LaheyKevin/Applied-IoT-Project-PoAB/relaismsofet correctie/relaismsofet correctie.png

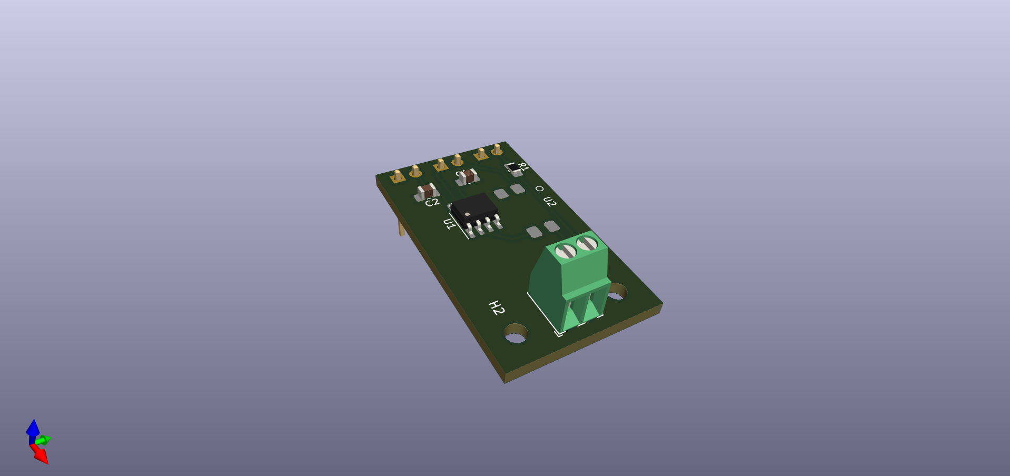
relaismsofet correctie/relaismsofet correctie.png
