LaheyKevin/Applied-IoT-Project-PoAB/stcs05/stc05-isoview.png

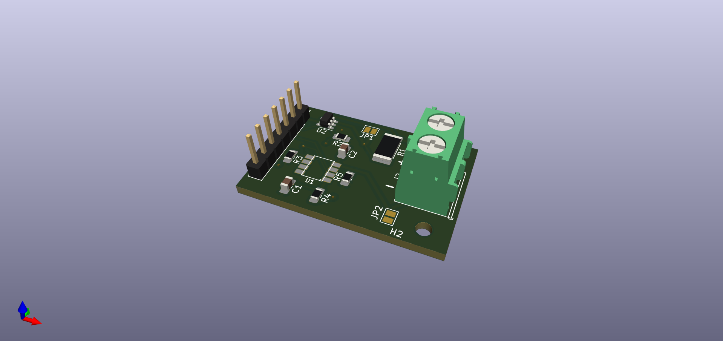
stcs05/stc05-isoview.png
