LaheyKevin/Applied-IoT-Project-PoAB/current regulator.docx

Current and voltage regulator

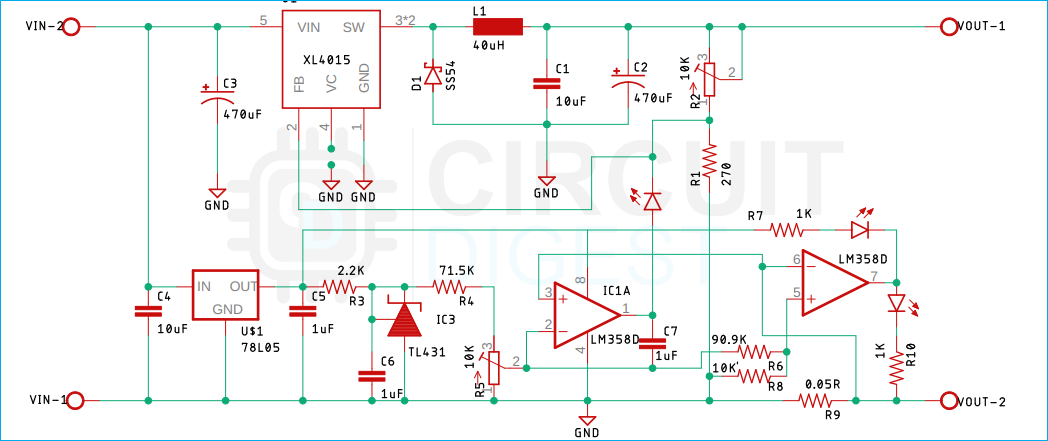
[picture p4: figure]
XL4015 DC-DC Buck Converter Schematic

Nadeel: chip moeilijk te vinden, circuit bevat batterijmeting die niet nodig is.

LM2673-adj

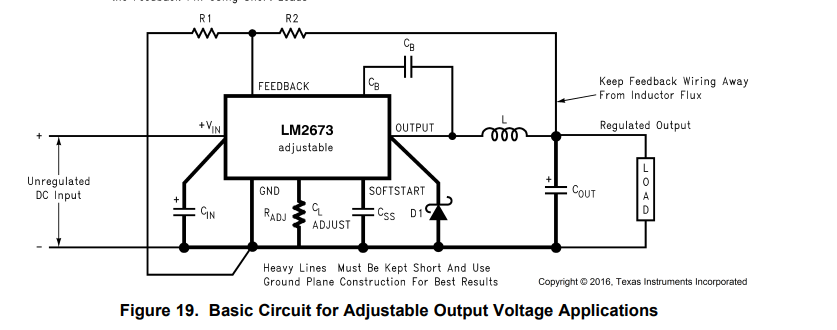
[picture p5: figure]

Te vinden op digikey,farnel, … vrij eenvoudig circuit.

Current sensor

Ina169:

IS=1A max

(3.3V * 1kΩ)/1A = 3300Ω
