LaheyKevin/Applied-IoT-Project-PoAB/POAB-aansturinglamp-Gerome-DeWilde.docx

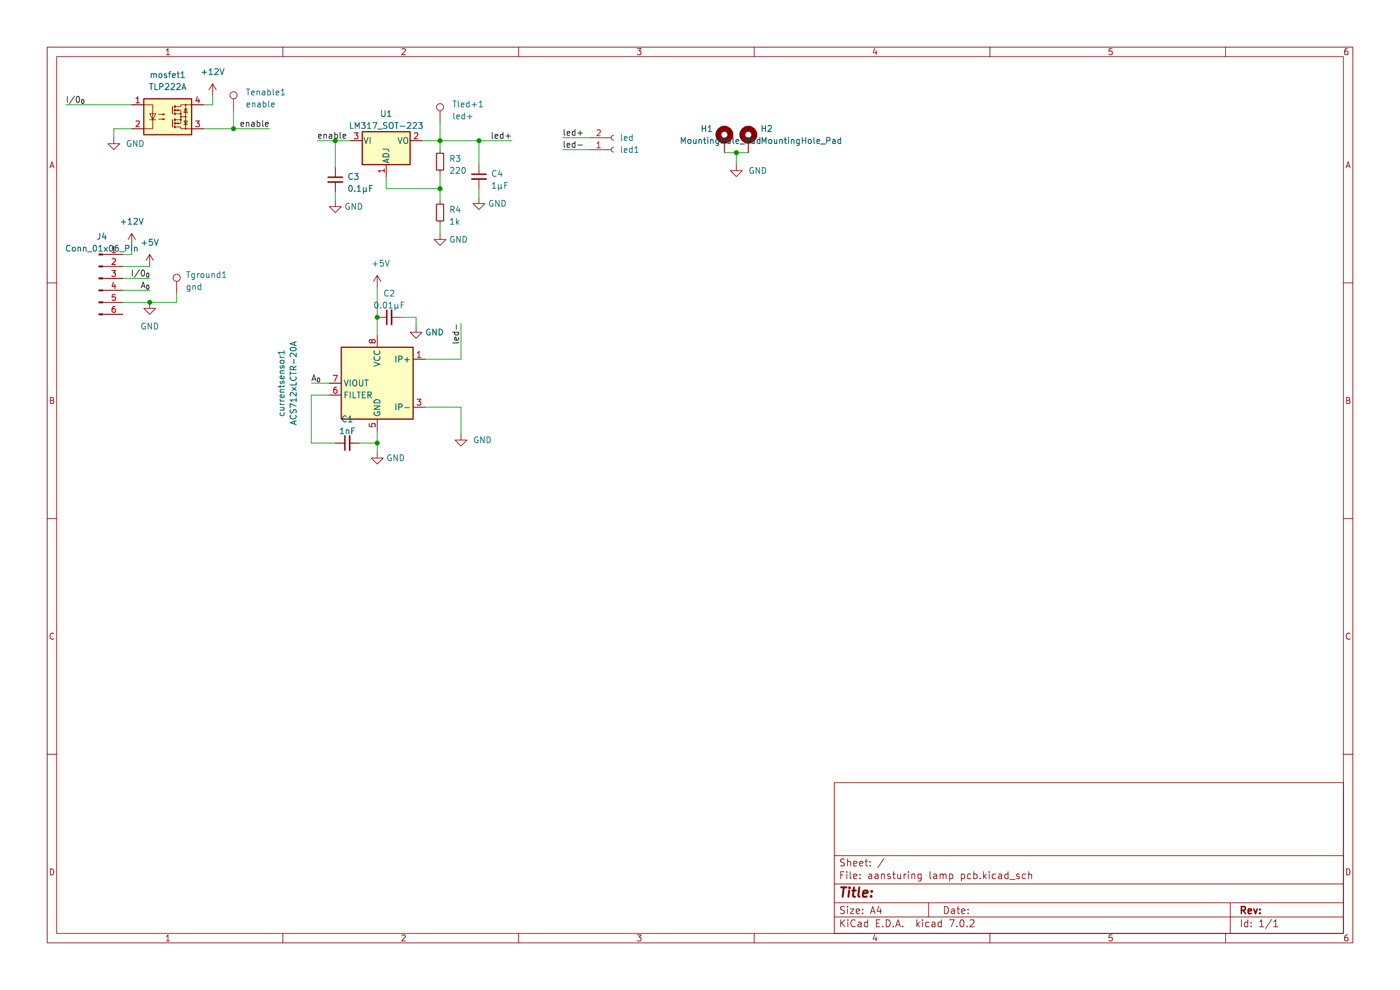
[picture p14: figure]
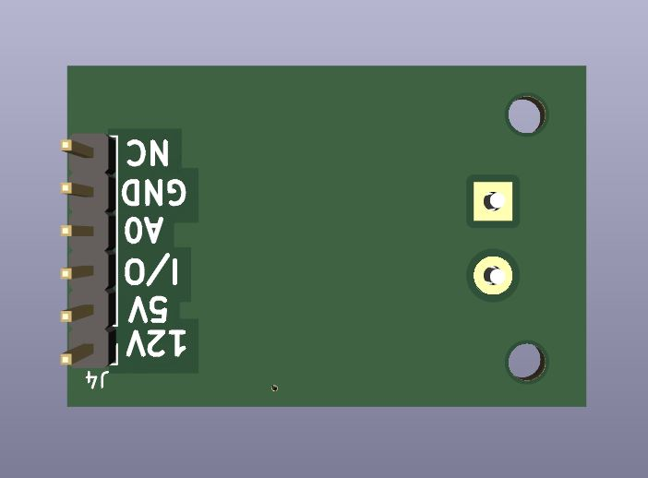
[picture p15: figure]
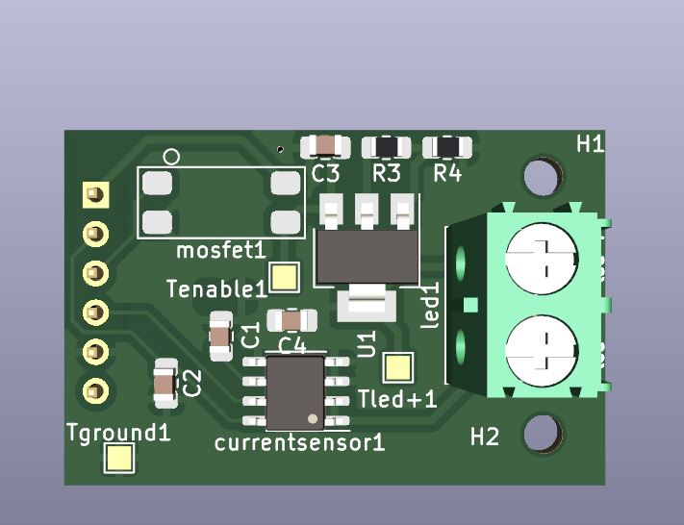
[picture p16: figure]
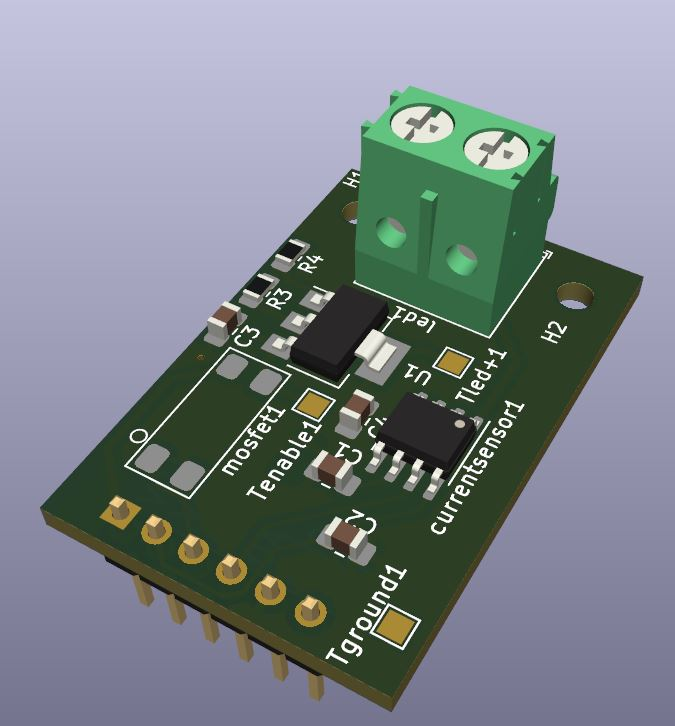
[picture p17: figure]
