LaheyKevin/Applied-IoT-Project-PoAB/baseboard/pcb design.PNG

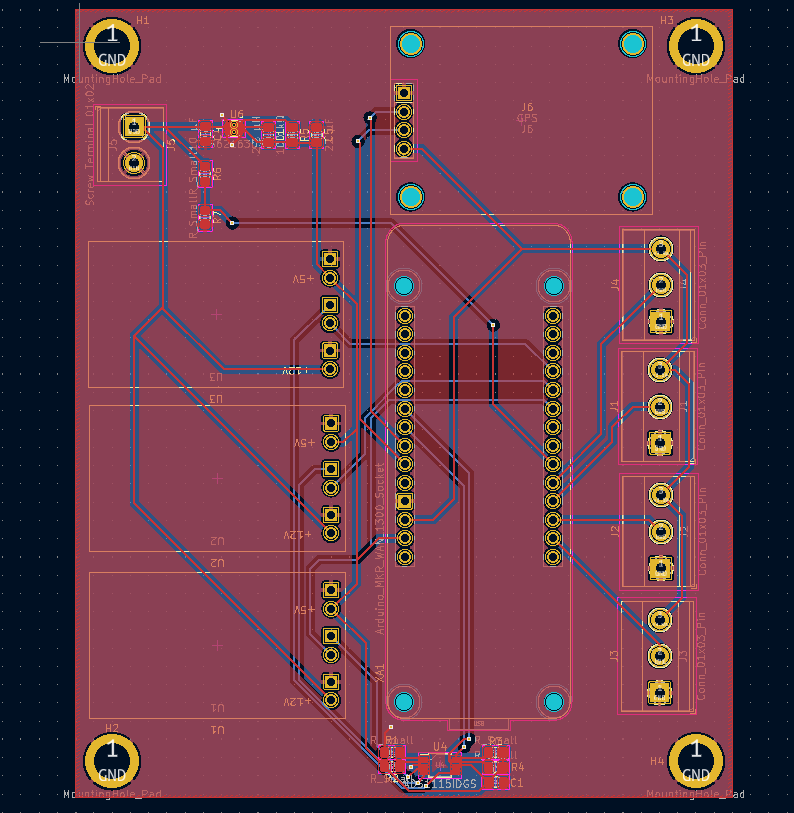
baseboard/pcb design.PNG
