LaheyKevin/Applied-IoT-Project-PoAB/elektisch schema.png

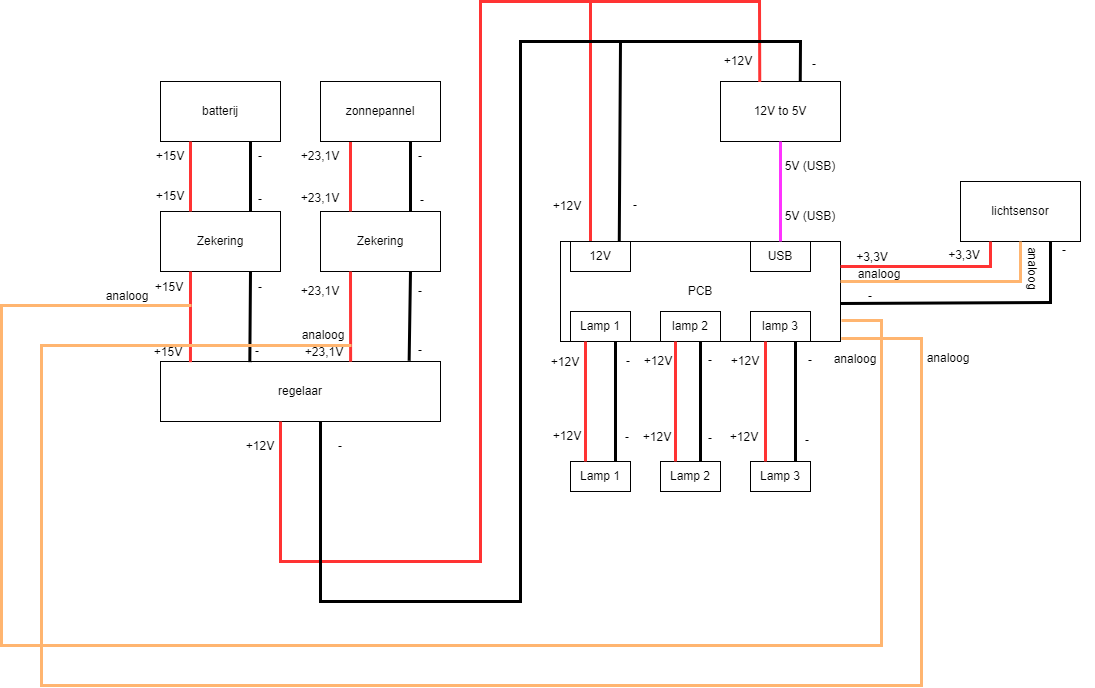
elektisch schema.png
