LaheyKevin/Applied-IoT-Project-PoAB/relaismsofet correctie/pcb design.PNG

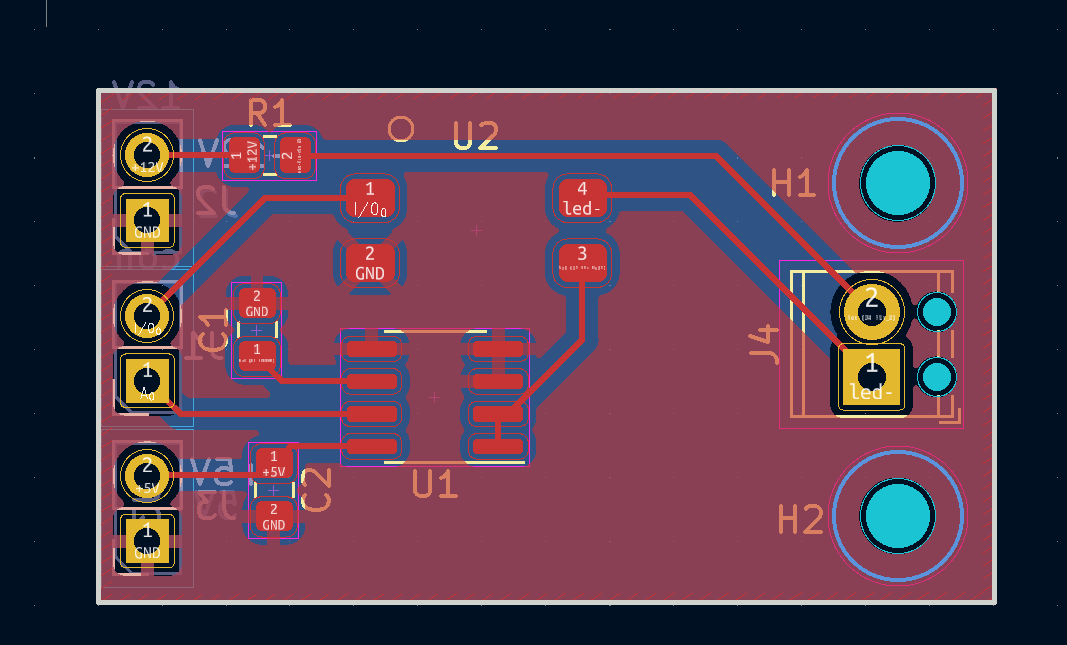
relaismsofet correctie/pcb design.PNG
