LaheyKevin/Applied-IoT-Project-PoAB/stcs05/pcb-design.PNG

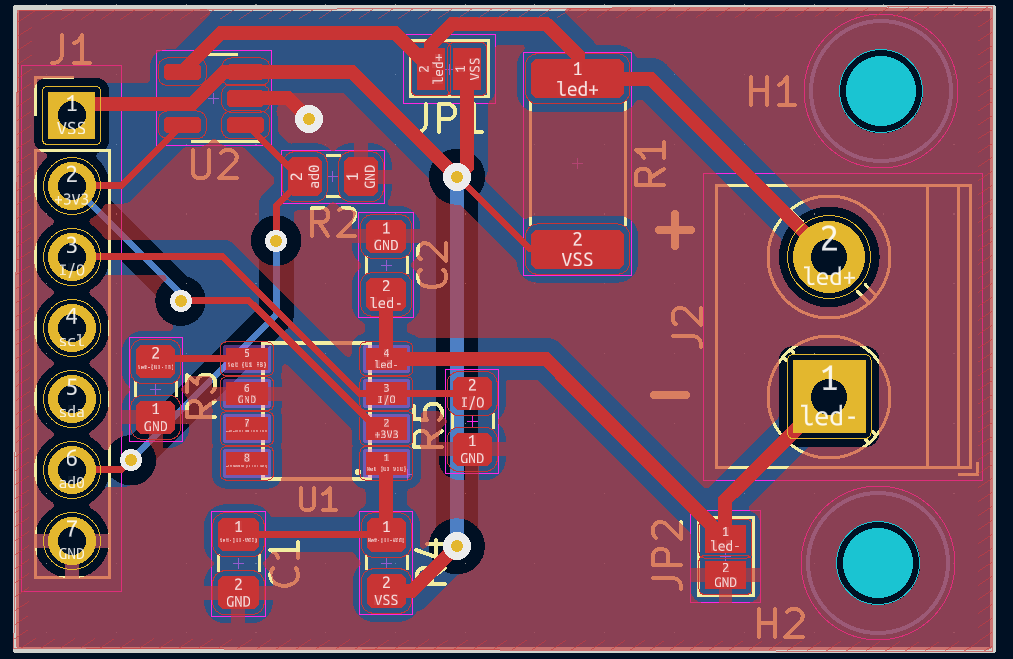
stcs05/pcb-design.PNG
