LaheyKevin/Applied-IoT-Project-PoAB/yorick_baseboard/baseboard/PCB-POAB-baseboard-3dview.png

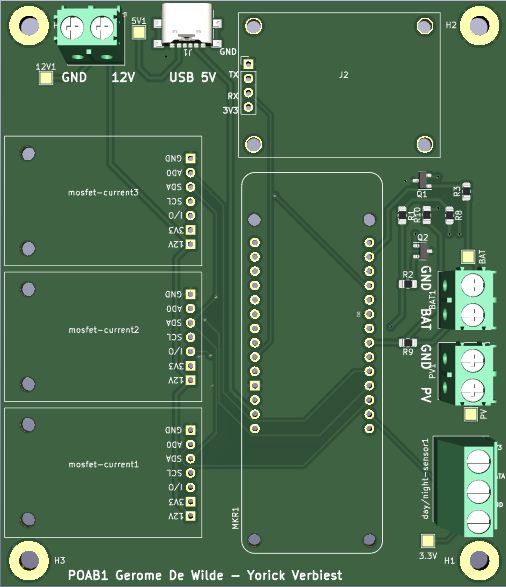
yorick_baseboard/baseboard/PCB-POAB-baseboard-3dview.png
