LaheyKevin/Applied-IoT-Project-PoAB/yorick_baseboard/baseboard/PCB-POAB-baseboard.png

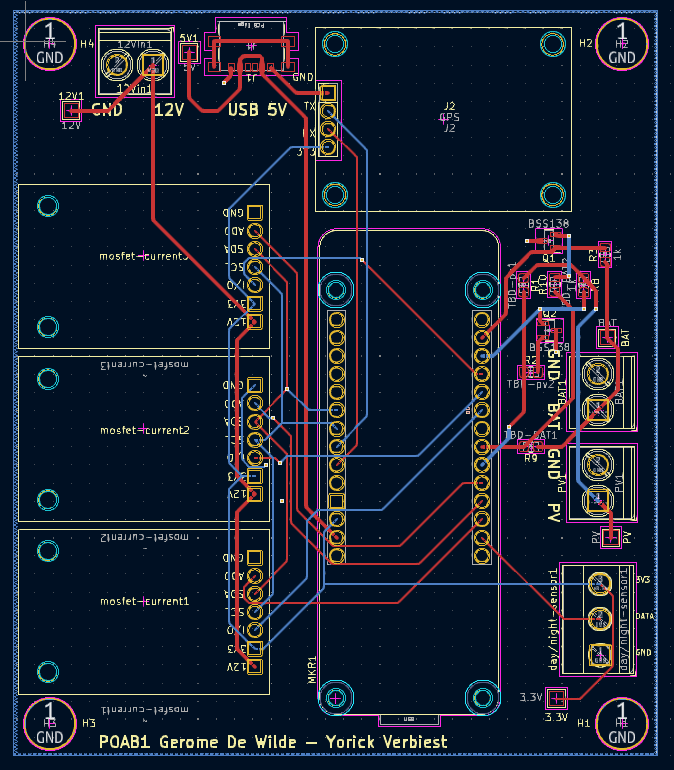
yorick_baseboard/baseboard/PCB-POAB-baseboard.png
