LaheyKevin/Applied-IoT-Project-PoAB/bestellijst light sensor.xlsx

 | light sensor
naam | link | aantal | prijs per stuk | prijs
light sensor | https://be.farnell.com/w/search/prl/resultaten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 | 1 | 1.38 | 1.38
10k ohm | https://be.farnell.com/yageo/rc0805fr-0710kl/res-10k-1-0-125w-0805-thick-film/dp/9237755 | 10 | 0.018 | 0.18
pcb | https://cart.jlcpcb.com/quote/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 | 5 |  | 1.82
 |  |  | totaal | 3.38
