LaheyKevin/Applied-IoT-Project-PoAB/bestellijst steering board.xlsx

 |  | steering board
naam | waarde | link | aantal | prijs per stuk | prijs
led-driver | stcs05 | https://be.farnell.com/stmicroelectronics/stcs05dr/led-driver-constant-current-soic/dp/3367114?st=stcs05 | 3 | 1.06 | 3.18
weerstand | 100 ohm | https://be.farnell.com/yageo/rc0805fr-07100rl/res-100r-1-0-125w-0805-thick-film/dp/9237364 | 10 | 0.018 | 0.18
weerstand | 470 ohm | https://be.farnell.com/yageo/rc0805fr-07470rl/res-470r-1-0-125w-0805-thick-film/dp/9237445 | 10 | 0.018 | 0.18
condensator | 0,47µF | https://be.farnell.com/tdk/cga4j3x8r1e474k125ad/cap-0-47-f-25v-10-x8r-0805/dp/2907072 | 5 | 0.045 | 0.225
condensator | 0,1µF | https://be.farnell.com/avx/08053c104jat2a/cap-0-1-f-25v-5-x7r-0805/dp/2332733 | 10 | 0.109 | 1.09
weerstand | 1 ohm | https://be.farnell.com/susumu/rl1220s-1r0-f/current-sense-res-1r-1-333-mw/dp/1612056 | 3 | 0.31 | 0.93
stroom-meter | ina169 | https://be.farnell.com/texas-instruments/ina169na-250/current-sense-amp-440khz-sot23/dp/3118124?st=ina169 | 3 | 2.66 | 7.98
weerstand | 10 ohm | https://be.farnell.com/bourns/crm2512-jw-1r0elf/current-sense-res-1r-5-2-w-2512/dp/1865268?ost=1865268 | 10 | 0.253 | 2.53
weerstand | 3k3 ohm | https://be.farnell.com/yageo/rc0805fr-073k3l/res-3k3-1-0-125w-0805-thick-film/dp/9237682 | 10 | 0.018 | 0.18
headers | 1x7 pin header | https://be.farnell.com/multicomp/2211s-07g/connector-header-7pos-1row-2-54mm/dp/2847165 | 1 | 0.047 | 0.047
screw terminal | screw terminal | https://be.farnell.com/multicomp/mc000046/terminal-block-wire-to-brd-2pos/dp/2008017?st=screw%20terminal%20pcb | 5 | 0.348 | 1.74
pcb | pcb | https://cart.jlcpcb.com/quote/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 | 5 |  | 3.64
 |  |  |  | totaal | 21.902
