LaheyKevin/Applied-IoT-Project-PoAB/relaismsofet correctie/relaismsofet correctie.pdf

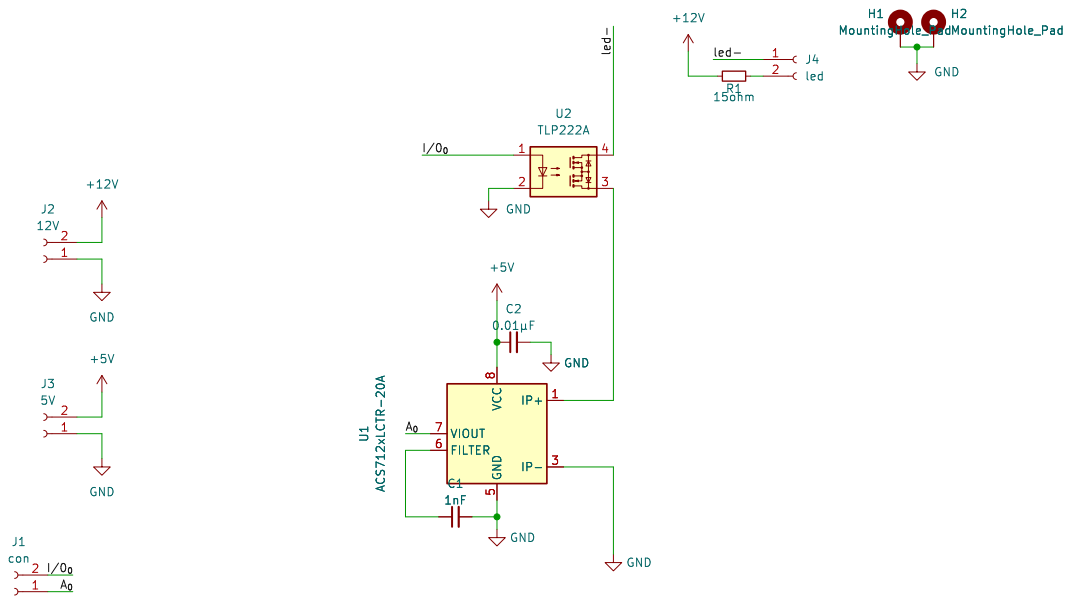
[picture p24: page 1]

Id: 1/1 Title: File: relaismosfet.kicad_sch Sheet: / GND
