LaheyKevin/Applied-IoT-Project-PoAB/yorick_baseboard/baseboard/PCB-POAB-baseboard-schema.pdf

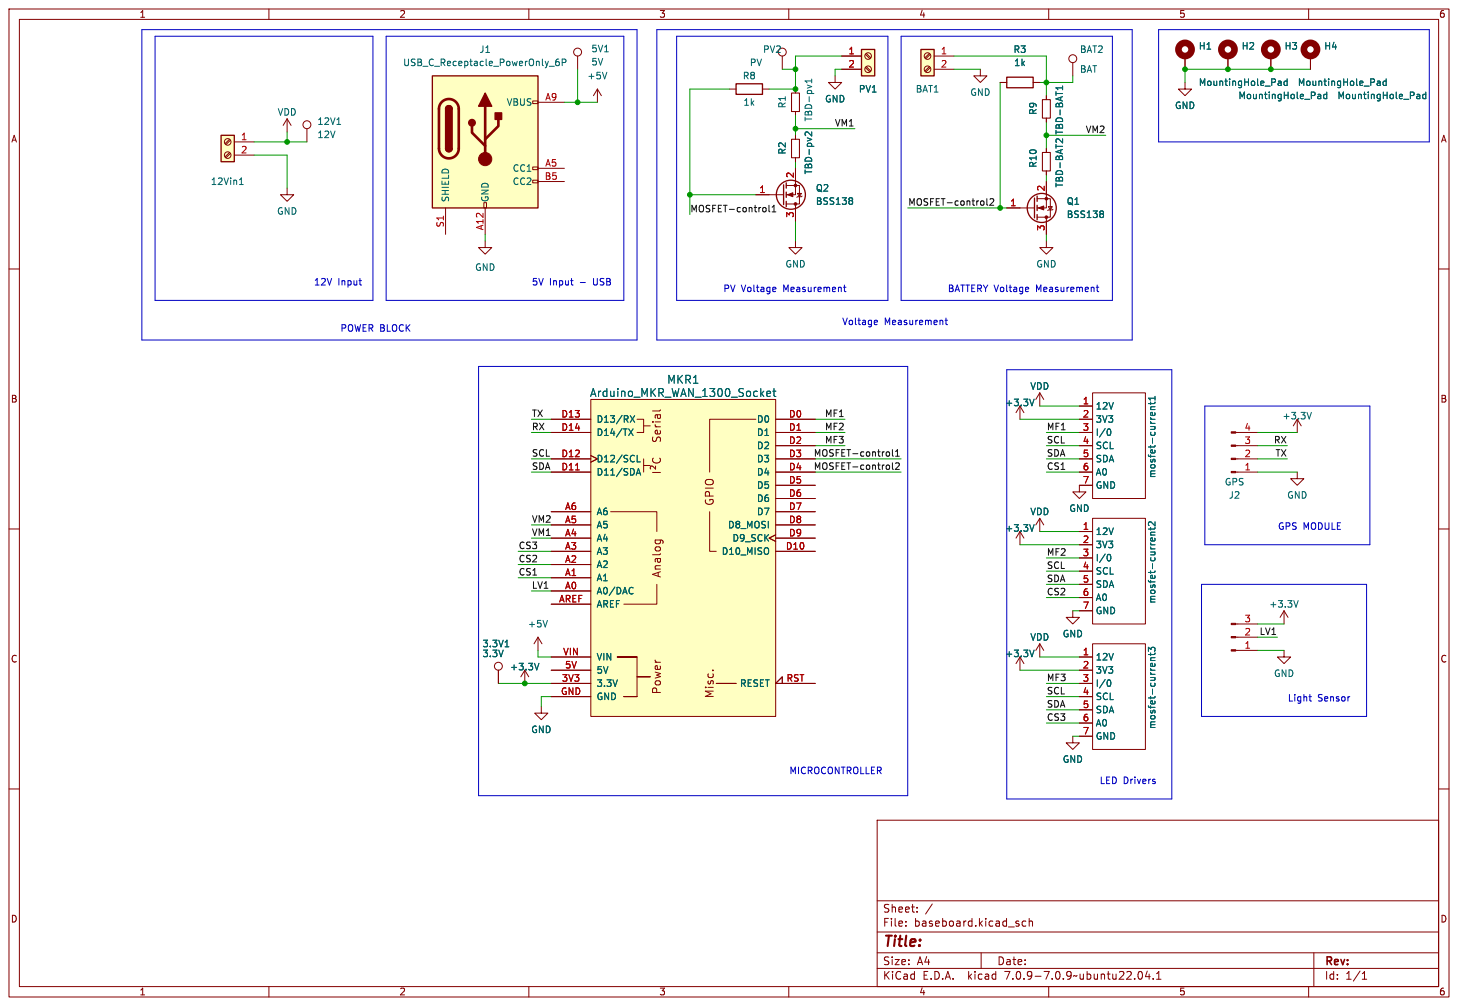
[picture p25: page 1]

Id: 1/1 Title: File: baseboard.kicad_sch Sheet: /
