LaheyKevin/Applied-IoT-Project-PoAB/baseboard/baseboard.pdf

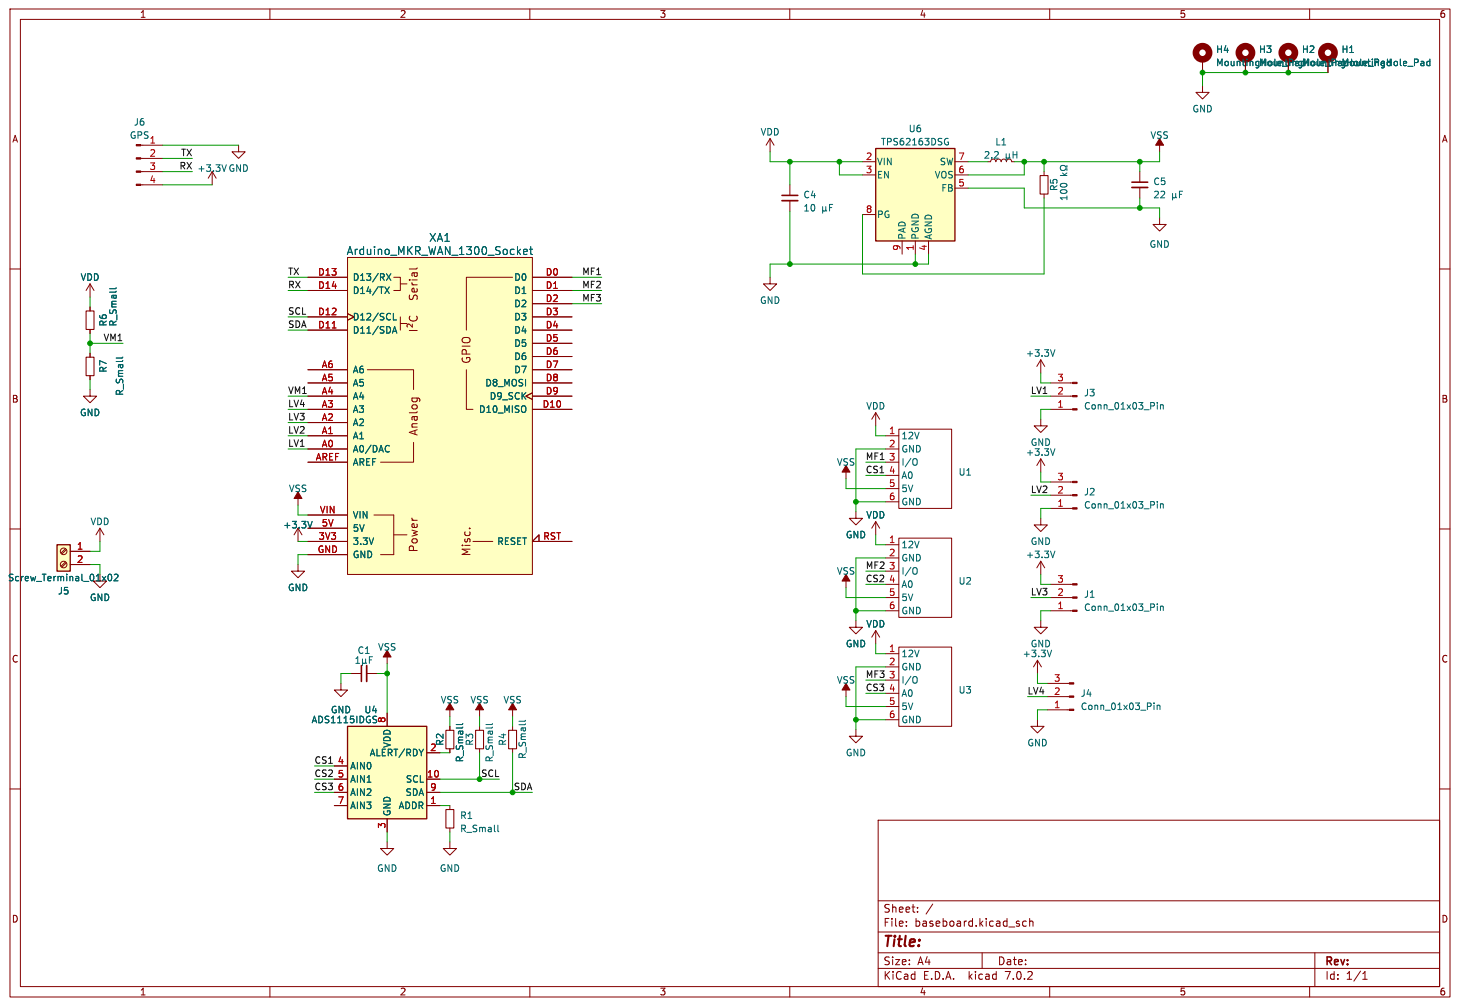
[picture p26: page 1]
