LaheyKevin/Applied-IoT-Project-PoAB/AL5801/testboard AL5801.kicad_pcb

## KiCad design AL5801/testboard AL5801.kicad_pcb (2024-01-11)

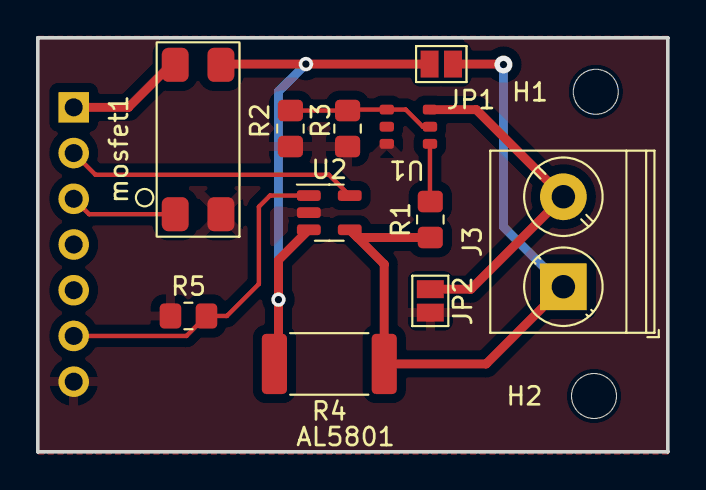
[picture p27: board testboard AL5801.kicad_pcb from above]

Board: 2 copper layers, 35.0 x 23.0 mm, 14 parts (1 on the bottom side), 10 nets.

Parts:
H1, H2: MountingHole_Pad; MountingHole_2.5mm
J1: Conn_01x07_Pin; PinHeader_1x07_P2.54mm_Vertical
J3: Screw_Terminal_01x02; TerminalBlock_Phoenix_PT-1,5-2-5.0-H_1x02_P5.00mm_Horizontal
JP1, JP2: SolderJumper_2_Open; SolderJumper-2_P1.3mm_Open_Pad1.0x1.5mm
R1, R2, R3: R; R_0805_2012Metric_Pad1.20x1.40mm_HandSolder
R4: Rs; R_2512_6332Metric_Pad1.40x3.35mm_HandSolder
R5: Rl; R_0805_2012Metric_Pad1.20x1.40mm_HandSolder
U1: AL5801W6-7; AL5801
U2: INA169; SOT-23-5
mosfet1: TLP222A; AQY211EHAZ

Connections:
+3V3: J1.2, U2.5 (V+)
/I/O: J1.3, mosfet1.1
/V_{in+}: JP1.1 (A), R4.2, U2.3 (+), mosfet1.3
/ad0: J1.6, R5.2, U2.1
/led+: J3.1, JP1.2 (B), R1.1, R4.1, U2.4 (-)
/led-: J3.2, JP2.1 (A), U1.3 (OUT)
GND: J1.7, JP2.2 (B), R2.2, R3.2, R5.1, U1.6 (GND), U2.2 (GND), mosfet1.2
unnamed: R1.2, U1.1 (BIAS)
unnamed: R2.1, R3.1, U1.2 (FB), U1.4 (REXT)
VSS: J1.1, mosfet1.4
