LaheyKevin/Applied-IoT-Project-PoAB/yorick_baseboard/baseboard/baseboard.kicad_pcb

## KiCad design yorick_baseboard/baseboard/baseboard.kicad_pcb (2024-01-11)

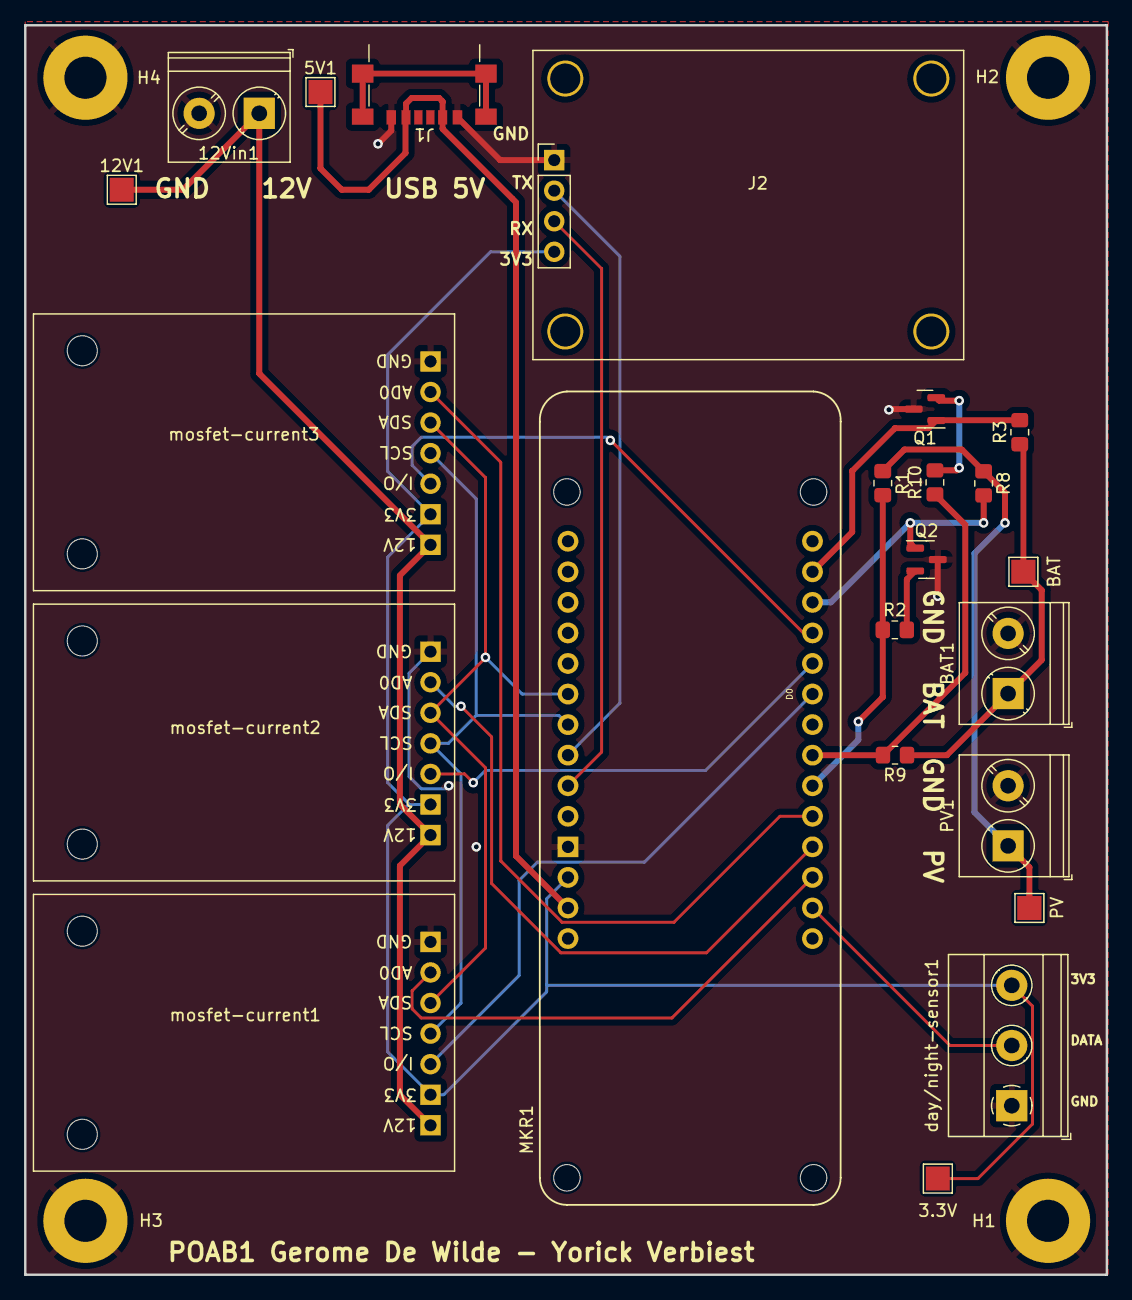
[picture p28: board yorick_baseboard/baseboard/baseboard.kicad_pcb from above]

Board: 2 copper layers, 89.9 x 103.8 mm, 27 parts (0 on the bottom side), 23 nets.

Parts:
3.3V: 3.3V; TestPoint_Pad_2.0x2.0mm
5V1: 5V; TestPoint_Pad_2.0x2.0mm
12V1: 12V; TestPoint_Pad_2.0x2.0mm
12Vin1: Screw_Terminal_01x02; TerminalBlock_Phoenix_PT-1,5-2-5.0-H_1x02_P5.00mm_Horizontal
BAT: BAT; TestPoint_Pad_2.0x2.0mm
BAT1: Screw_Terminal_01x02; TerminalBlock_Phoenix_PT-1,5-2-5.0-H_1x02_P5.00mm_Horizontal
H1, H2, H3, H4: MountingHole_Pad; MountingHole_3.5mm_Pad
J1: USB_C_Receptacle_PowerOnly_6P; USB_C_Receptacle_GCT_USB4135-GF-A_6P_TopMnt_Horizontal
J2: GPS; GYS-GPS
MKR1: Arduino_MKR_WAN_1300_Socket; Arduino_MKR_FOX_1200_Socket
PV: PV; TestPoint_Pad_2.0x2.0mm
PV1: Screw_Terminal_01x02; TerminalBlock_Phoenix_PT-1,5-2-5.0-H_1x02_P5.00mm_Horizontal
Q1, Q2: BSS138; SOT-23
R1: TBD-pv1; R_0805_2012Metric_Pad1.20x1.40mm_HandSolder
R2: TBD-pv2; R_0805_2012Metric_Pad1.20x1.40mm_HandSolder
R3, R8: 1k; R_0805_2012Metric_Pad1.20x1.40mm_HandSolder
R9: TBD-BAT1; R_0805_2012Metric_Pad1.20x1.40mm_HandSolder
R10: TBD-BAT2; R_0805_2012Metric_Pad1.20x1.40mm_HandSolder
day/night-sensor1: Conn_01x03_Pin; TerminalBlock_Phoenix_MKDS-1,5-3_1x03_P5.00mm_Horizontal
mosfet-current1, mosfet-current2, mosfet-current3: mosfet-current

Connections:
+3.3V: 3.3V.1, J2.4, MKR1.3V3 (3.3V), day/night-sensor1.3, mosfet-current1.2 (3V3), mosfet-current2.2 (3V3), mosfet-current3.2 (3V3)
+5V: 5V1.1, J1.A9 (VBUS), J1.B9 (VBUS), MKR1.VIN
/CS1: MKR1.A1, mosfet-current1.6 (A0)
/CS2: MKR1.A2, mosfet-current2.6 (A0)
/CS3: MKR1.A3, mosfet-current3.6 (A0)
/LV1: MKR1.A0 (A0/DAC), day/night-sensor1.2
/MF1: MKR1.D0, mosfet-current1.3 (I/0)
/MF2: MKR1.D1, mosfet-current2.3 (I/0)
/MF3: MKR1.D2, mosfet-current3.3 (I/0)
/MOSFET-control1: MKR1.D3, Q2.1 (G), R8.2
/MOSFET-control2: MKR1.D4, Q1.1 (G), R3.2
/RX: J2.3, MKR1.D14 (D14/TX)
/SCL: MKR1.D12 (D12/SCL), mosfet-current1.4 (SCL), mosfet-current2.4 (SCL), mosfet-current3.4 (SCL)
/SDA: MKR1.D11 (D11/SDA), mosfet-current1.5 (SDA), mosfet-current2.5 (SDA), mosfet-current3.5 (SDA)
/TX: J2.2, MKR1.D13 (D13/RX)
/VM1: MKR1.A4, R1.2, R2.1
/VM2: MKR1.A5, R9.2, R10.1
GND: 12Vin1.2, BAT1.2, H1.1, H2.1, H3.1, H4.1, J1.A12 (GND), J1.B12 (GND), J2.1, MKR1.GND, PV1.2, Q1.3 (D), Q2.3 (D), day/night-sensor1.1, mosfet-current1.7 (GND), mosfet-current2.7 (GND), mosfet-current3.7 (GND)
unnamed: BAT.1, BAT1.1, R3.1, R9.1
unnamed: PV.1, PV1.1, R1.1, R8.1
unnamed: Q1.2 (S), R10.2
unnamed: Q2.2 (S), R2.2
VDD: 12V1.1, 12Vin1.1, mosfet-current1.1 (12V), mosfet-current2.1 (12V), mosfet-current3.1 (12V)
