LaheyKevin/Applied-IoT-Project-PoAB/board_TEMT6000_waterclosedcase/board_TEMT6000_waterclosedcase.kicad_pcb

## KiCad design board_TEMT6000_waterclosedcase/board_TEMT6000_waterclosedcase.kicad_pcb (2024-01-11)

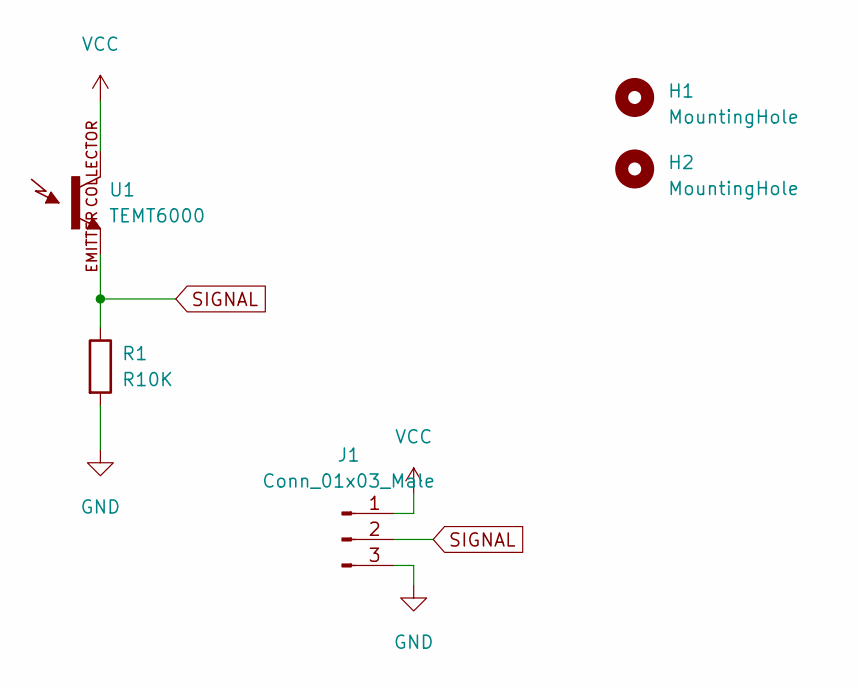
[picture p29: schematic board_TEMT6000_waterclosedcase.kicad_sch]

Parts:
H1, H2: MountingHole; MountingHole_3.2mm_M3_DIN965_Pad_TopOnly
J1: Conn_01x03_Male; SolderWire-0.1sqmm_1x03_P3.6mm_D0.4mm_OD1mm_Relief
R1: R10K; R_0805_2012Metric_Pad1.20x1.40mm_HandSolder
U1: TEMT6000; TEMT6000-SEN

Connections:
GND: J1.3, R1.2
SIGNAL: J1.2, R1.1, U1.EMITTER
VCC: J1.1, U1.COLLECTOR

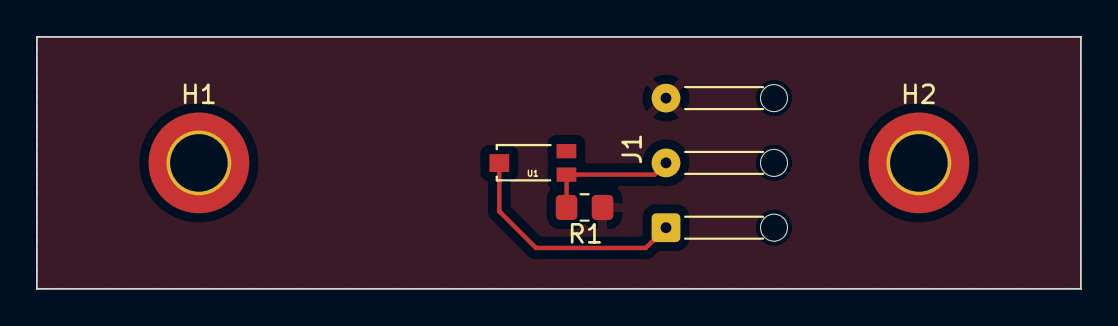
[picture p30: board board_TEMT6000_waterclosedcase.kicad_pcb from above]

Board: 2 copper layers, 58.0 x 14.0 mm, 5 parts (0 on the bottom side), 3 nets.
