LaheyKevin/Applied-IoT-Project-PoAB/aansturing lamp pcb/aansturing lamp pcb.kicad_pcb

## KiCad design aansturing lamp pcb/aansturing lamp pcb.kicad_pcb (2023-10-26)

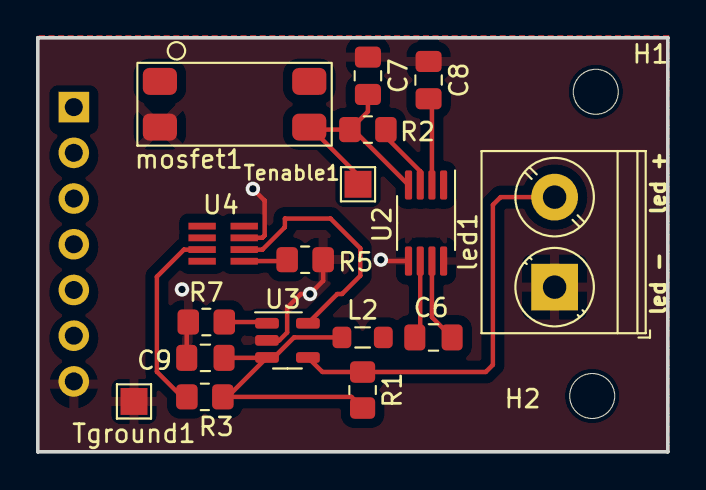
[picture p31: board aansturing lamp pcb.kicad_pcb from above]

Board: 2 copper layers, 35.0 x 23.0 mm, 20 parts (1 on the bottom side), 16 nets.

Parts:
C6: C_boost; C_0805_2012Metric_Pad1.18x1.45mm_HandSolder
C7: C_Small; C_0805_2012Metric_Pad1.18x1.45mm_HandSolder
C8: Cvcc; C_0805_2012Metric_Pad1.18x1.45mm_HandSolder
C9: C_out; C_0805_2012Metric_Pad1.18x1.45mm_HandSolder
H1, H2: MountingHole_Pad; MountingHole_2.5mm
J1: Conn_01x07_Pin; PinHeader_1x07_P2.54mm_Vertical
L2: L_Small; L_0805_2012Metric_Pad1.05x1.20mm_HandSolder
R1: Rs; R_0805_2012Metric_Pad1.20x1.40mm_HandSolder
R2: R_en; R_0805_2012Metric_Pad1.20x1.40mm_HandSolder
R3: R50K; R_0805_2012Metric_Pad1.20x1.40mm_HandSolder
R5: Rb; R_0805_2012Metric_Pad1.20x1.40mm_HandSolder
R7: Rl; R_0805_2012Metric_Pad1.20x1.40mm_HandSolder
Tenable1: enable; TestPoint_Pad_1.5x1.5mm
Tground1: gnd; TestPoint_Pad_1.5x1.5mm
U2: MCP16311MS; MSOP-8_3x3mm_P0.65mm
U3: INA169; SOT-23-5
U4: AD5245BRJZ50-RL7; SOT65P280X145-8N
led1: led; TerminalBlock_Phoenix_PT-1,5-2-5.0-H_1x02_P5.00mm_Horizontal
mosfet1: TLP222A; AQY211EHAZ

Connections:
+3.3V: J1.2, U3.5 (V+), U4.2 (VDD)
+12V: J1.1, mosfet1.4
/I/0_{0}: J1.3, mosfet1.1
/R_{digin}: R3.2, U4.7 (B)
/R_{digout}: R5.1, U4.1 (W)
/ad0: J1.6, R7.2, U3.1, U4.6 (AD0)
/enable: C7.2, R2.1, Tenable1.1, U2.4 (Vin), mosfet1.3
/led+: R1.1, U3.4 (-), led1.2
/scl: J1.4, U4.4 (SCL)
/sda: J1.5, U4.5 (SDA)
/stroom+: C9.1, L2.2, R1.2, R3.1, U3.3 (+)
GND: C7.1, C8.1, C9.2, J1.7, R5.2, R7.1, Tground1.1, U2.5 (PGND), U2.8 (AGND), U3.2 (GND), U4.3 (GND), led1.1, mosfet1.2
unnamed: C6.2, U2.7 (BOOST)
unnamed: R2.2, U2.3 (EN)
unnamed: C6.1, L2.1, U2.6 (SW)
unnamed: C8.2, U2.2 (Vcc)
