LaheyKevin/Applied-IoT-Project-PoAB/optie 2 aansturing/optie 2 aansturing.kicad_pcb

## KiCad design optie 2 aansturing/optie 2 aansturing.kicad_pcb (2023-10-26)

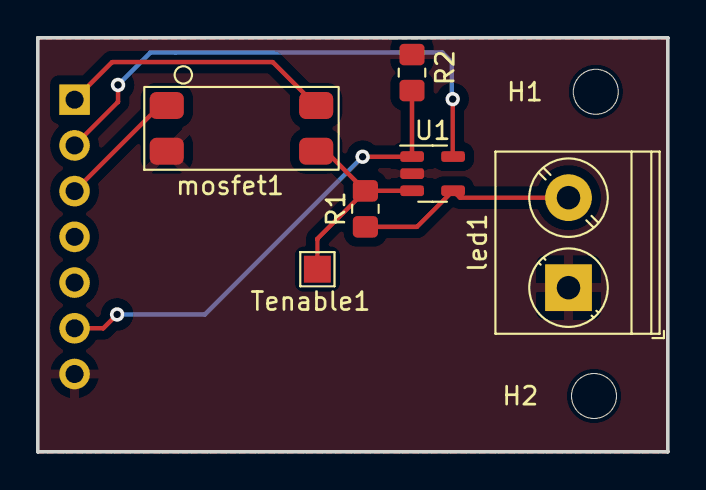
[picture p32: board optie 2 aansturing.kicad_pcb from above]

Board: 2 copper layers, 35.0 x 23.0 mm, 9 parts (1 on the bottom side), 7 nets.

Parts:
H1, H2: MountingHole_Pad; MountingHole_2.5mm
J1: Conn_01x07_Pin; PinHeader_1x07_P2.54mm_Vertical
R1: Rs; R_0805_2012Metric_Pad1.20x1.40mm_HandSolder
R2: Rl; R_0805_2012Metric_Pad1.20x1.40mm_HandSolder
Tenable1: enable; TestPoint_Pad_1.5x1.5mm
U1: INA169; SOT-23-5
led1: led; TerminalBlock_Phoenix_PT-1,5-2-5.0-H_1x02_P5.00mm_Horizontal
mosfet1: TLP222A; AQY211EHAZ

Connections:
+3.3V: J1.2, U1.5 (V+)
+12V: J1.1, mosfet1.4
/I/0_{0}: J1.3, mosfet1.1
/ad0: J1.6, R2.2, U1.1
/enable: R1.2, Tenable1.1, U1.3 (+), mosfet1.3
/led+: R1.1, U1.4 (-), led1.2
GND: J1.7, R2.1, U1.2 (GND), led1.1, mosfet1.2
