LaheyKevin/Applied-IoT-Project-PoAB/baseboard/baseboard.kicad_pcb

## KiCad design baseboard/baseboard.kicad_pcb (2023-09-21)

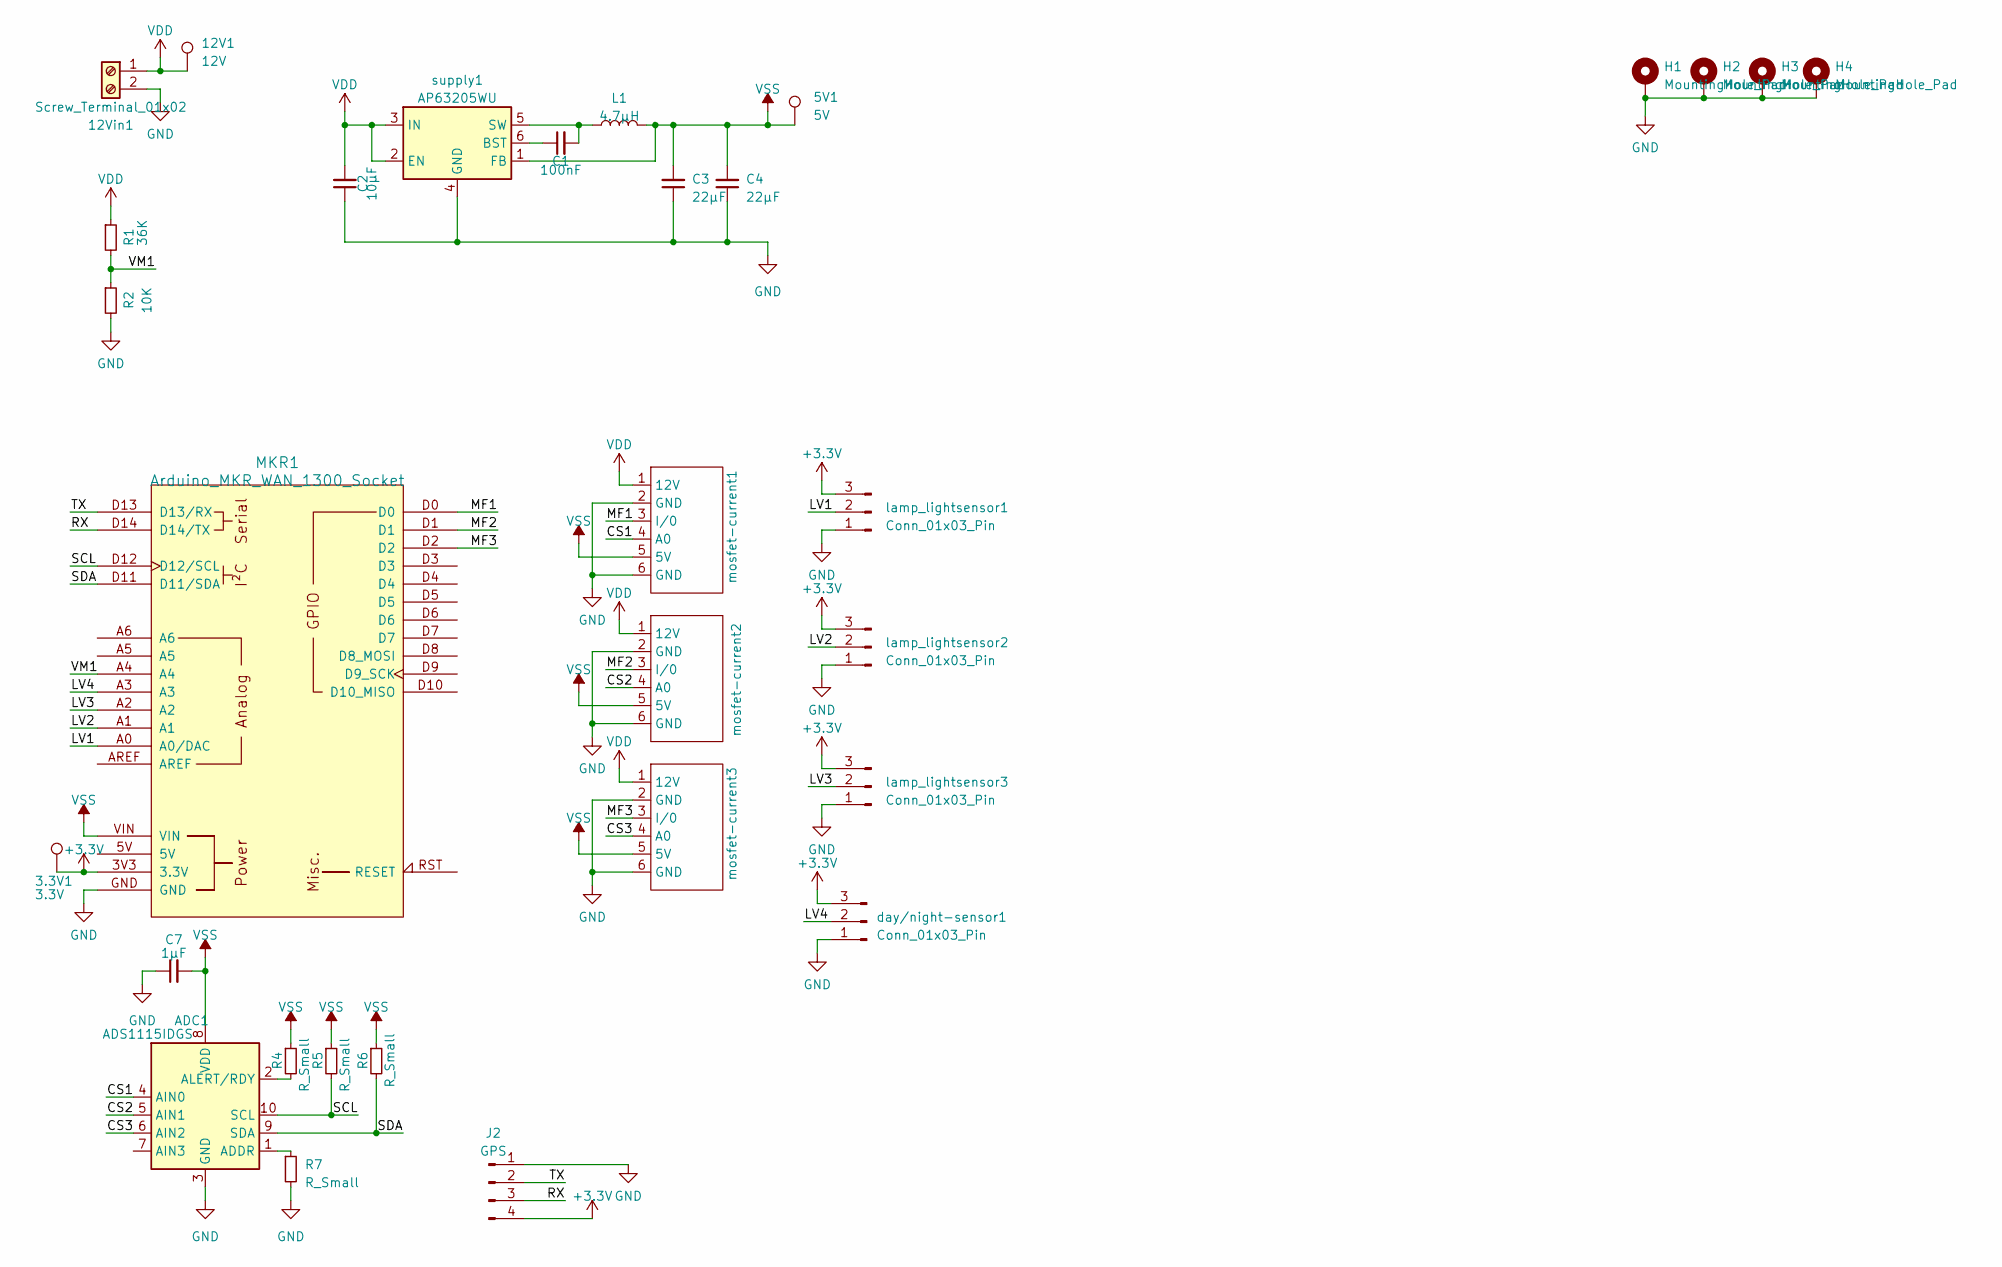
[picture p33: schematic baseboard.kicad_sch]

Parts:
3.3V1: 3.3V; TestPoint_Pad_2.0x2.0mm
5V1: 5V; TestPoint_Pad_2.0x2.0mm
12V1: 12V; TestPoint_Pad_2.0x2.0mm
12Vin1: Screw_Terminal_01x02; TerminalBlock_Phoenix_PT-1,5-2-5.0-H_1x02_P5.00mm_Horizontal
ADC1: ADS1115IDGS; TSSOP-10_3x3mm_P0.5mm
C1: 100nF; C_0805_2012Metric_Pad1.18x1.45mm_HandSolder
C2: 10µF; C_0805_2012Metric_Pad1.18x1.45mm_HandSolder
C3, C4: 22µF; C_0805_2012Metric_Pad1.18x1.45mm_HandSolder
C7: 1µF; C_0805_2012Metric_Pad1.18x1.45mm_HandSolder
H1, H2, H3, H4: MountingHole_Pad; MountingHole_3.5mm_Pad
J2: GPS; GYS-GPS
L1: 4.7µH; L_0805_2012Metric_Pad1.15x1.40mm_HandSolder
MKR1: Arduino_MKR_WAN_1300_Socket; Arduino_MKR_FOX_1200_Socket
R1: 36K; R_0805_2012Metric_Pad1.20x1.40mm_HandSolder
R2: 10K; R_0805_2012Metric_Pad1.20x1.40mm_HandSolder
R4, R5, R6, R7: R_Small; R_0805_2012Metric_Pad1.20x1.40mm_HandSolder
day/night-sensor1: Conn_01x03_Pin; TerminalBlock_Phoenix_MKDS-1,5-3_1x03_P5.00mm_Horizontal
lamp_lightsensor1, lamp_lightsensor2, lamp_lightsensor3: Conn_01x03_Pin; TerminalBlock_Phoenix_MKDS-1,5-3_1x03_P5.00mm_Horizontal
mosfet-current1, mosfet-current2, mosfet-current3: mosfet-current
supply1: AP63205WU; TSOT-23-6

Connections:
+3.3V: 3.3V1.1, J2.4, MKR1.3V3 (3.3V), day/night-sensor1.3, lamp_lightsensor1.3, lamp_lightsensor2.3, lamp_lightsensor3.3
/CS1: ADC1.4 (AIN0), mosfet-current1.4 (A0)
/CS2: ADC1.5 (AIN1), mosfet-current2.4 (A0)
/CS3: ADC1.6 (AIN2), mosfet-current3.4 (A0)
/LV1: MKR1.A0 (A0/DAC), lamp_lightsensor1.2
/LV2: MKR1.A1, lamp_lightsensor2.2
/LV3: MKR1.A2, lamp_lightsensor3.2
/LV4: MKR1.A3, day/night-sensor1.2
/MF1: MKR1.D0, mosfet-current1.3 (I/0)
/MF2: MKR1.D1, mosfet-current2.3 (I/0)
/MF3: MKR1.D2, mosfet-current3.3 (I/0)
/RX: J2.3, MKR1.D14 (D14/TX)
/SCL: ADC1.10 (SCL), MKR1.D12 (D12/SCL), R5.2
/SDA: ADC1.9 (SDA), MKR1.D11 (D11/SDA), R6.2
/TX: J2.2, MKR1.D13 (D13/RX)
/VM1: MKR1.A4, R1.2, R2.1
GND: 12Vin1.2, ADC1.3 (GND), C2.1, C3.1, C4.1, C7.1, H1.1, H2.1, H3.1, H4.1, J2.1, MKR1.GND, R2.2, R7.2, day/night-sensor1.1, lamp_lightsensor1.1, lamp_lightsensor2.1, lamp_lightsensor3.1, mosfet-current1.2 (GND), mosfet-current1.6 (GND), mosfet-current2.2 (GND), mosfet-current2.6 (GND), mosfet-current3.2 (GND), mosfet-current3.6 (GND), supply1.4 (GND)
unnamed: ADC1.1 (ADDR), R7.1
unnamed: ADC1.2 (ALERT/RDY), R4.2
unnamed: C1.1, supply1.6 (BST)
unnamed: C1.2, L1.1, supply1.5 (SW)
VDD: 12V1.1, 12Vin1.1, C2.2, R1.1, mosfet-current1.1 (12V), mosfet-current2.1 (12V), mosfet-current3.1 (12V), supply1.2 (EN), supply1.3 (IN)
VSS: 5V1.1, ADC1.8 (VDD), C3.2, C4.2, C7.2, L1.2, MKR1.VIN, R4.1, R5.1, R6.1, mosfet-current1.5 (5V), mosfet-current2.5 (5V), mosfet-current3.5 (5V), supply1.1 (FB)

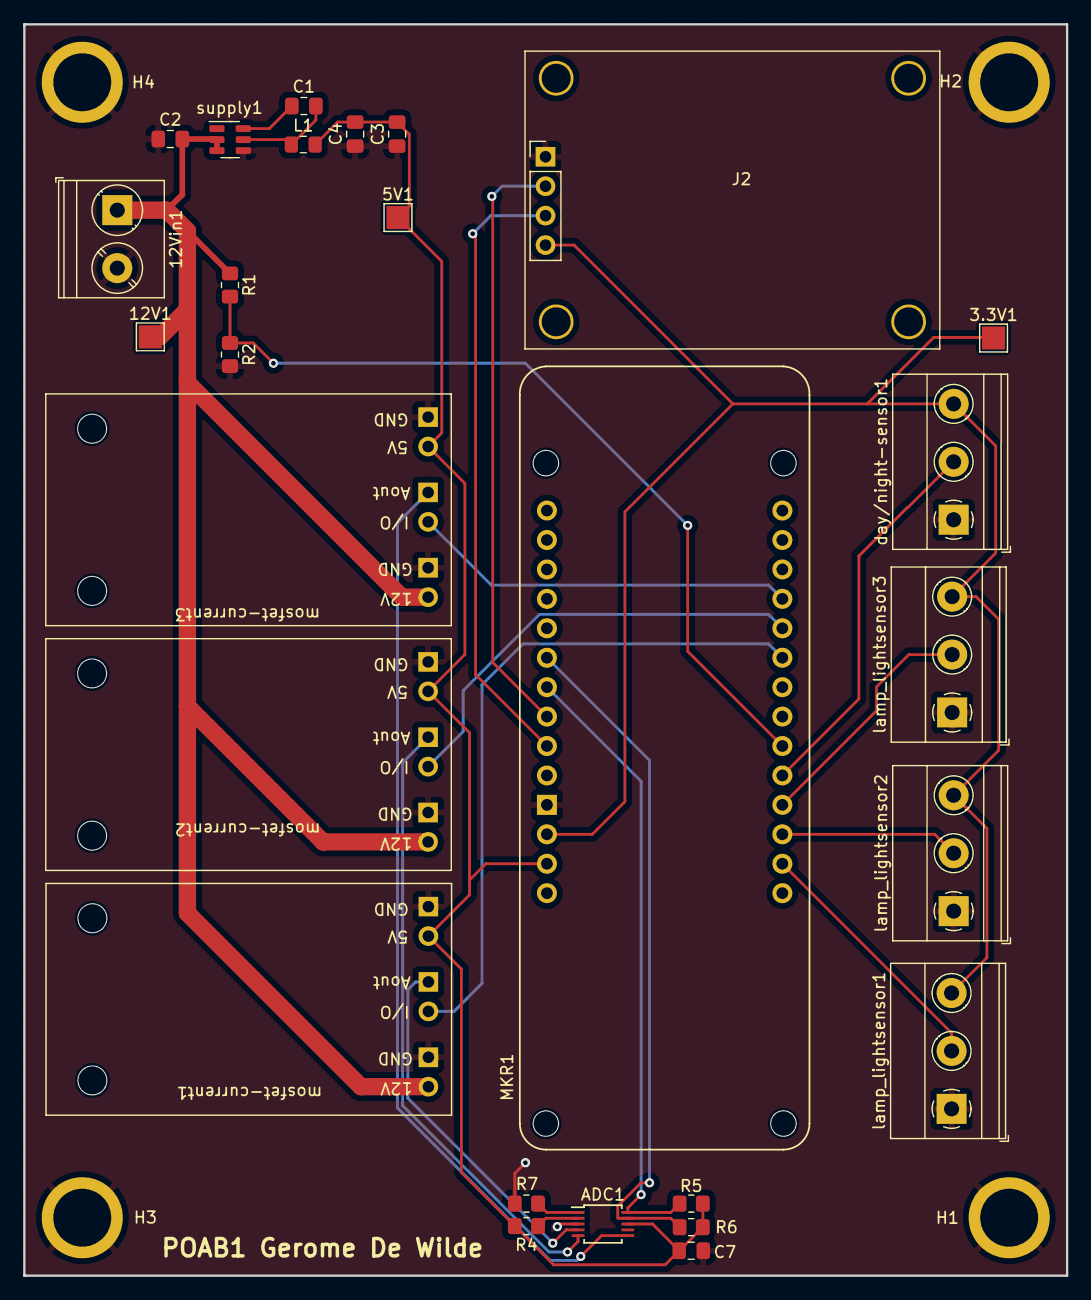
[picture p34: board baseboard/baseboard.kicad_pcb from above]

Board: 2 copper layers, 90.0 x 108.0 mm, 31 parts (0 on the bottom side), 23 nets.
