LaheyKevin/Applied-IoT-Project-PoAB/relaismsofet correctie/relaismsofet correctie.kicad_pcb

## KiCad design relaismsofet correctie/relaismsofet correctie.kicad_pcb (2023-09-21)

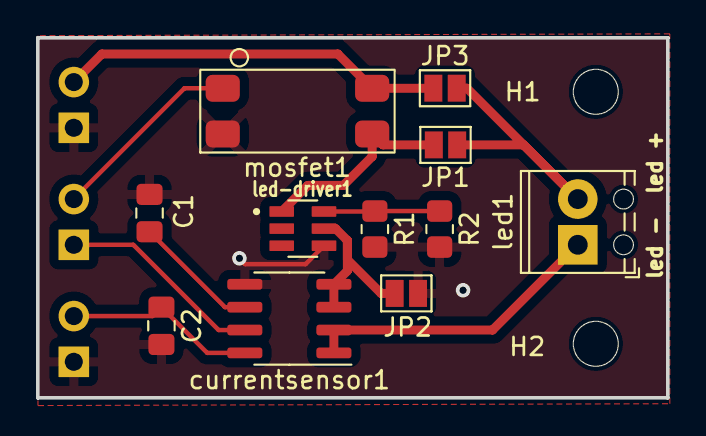
[picture p35: board relaismsofet correctie.kicad_pcb from above]

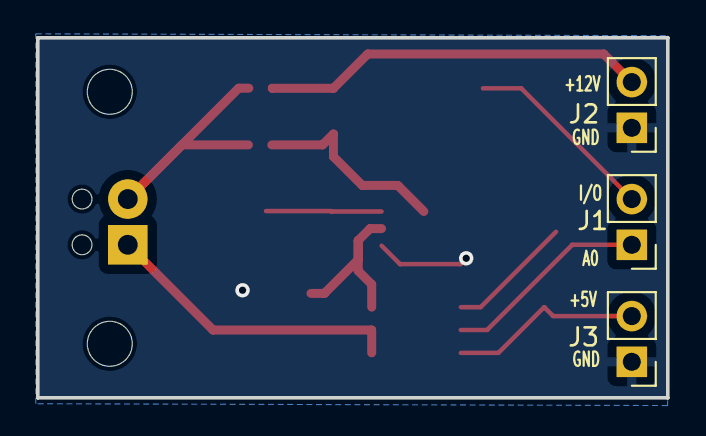
[picture p36: board relaismsofet correctie.kicad_pcb from below]

Board: 2 copper layers, 35.0 x 20.0 mm, 16 parts (3 on the bottom side), 11 nets.

Parts:
C1: 1nF; C_0805_2012Metric_Pad1.18x1.45mm_HandSolder
C2: 0.01µF; C_0805_2012Metric_Pad1.18x1.45mm_HandSolder
H1, H2: MountingHole_Pad; MountingHole_2.5mm
J1: con; PinHeader_1x02_P2.54mm_Vertical
J2: 12V; PinHeader_1x02_P2.54mm_Vertical
J3: 5V; PinHeader_1x02_P2.54mm_Vertical
JP1, JP2, JP3: SolderJumper_2_Open; SolderJumper-2_P1.3mm_Open_Pad1.0x1.5mm
R1, R2: R_Small; R_0805_2012Metric_Pad1.20x1.40mm_HandSolder
currentsensor1: ACS712xLCTR-20A; SOIC-8_3.9x4.9mm_P1.27mm
led1: led; TerminalBlock_Phoenix_MPT-0,5-2-2.54_1x02_P2.54mm_Horizontal
led-driver1: BCR421UW6Q-7; SOT95P285X140-6N
mosfet1: TLP222A; AQY211EHAZ

Connections:
+5V: C2.1, J3.2, currentsensor1.8 (VCC)
+12V: J2.2, JP3.1 (A), mosfet1.4
/A_{0}: J1.1, currentsensor1.7 (VIOUT)
/I/0_{0}: J1.2, mosfet1.1
/enable: JP1.2 (B), led-driver1.1 (EN), mosfet1.3
/led+: JP1.1 (A), JP3.2 (B), led1.2
/led-: currentsensor1.1 (IP+), currentsensor1.2 (IP+), led1.1
/out: JP2.1 (A), currentsensor1.3 (IP-), currentsensor1.4 (IP-), led-driver1.5 (OUT)
GND: C1.2, C2.2, J2.1, J3.1, JP2.2 (B), R1.2, R2.2, currentsensor1.5 (GND), led-driver1.4 (GND), mosfet1.2
unnamed: C1.1, currentsensor1.6 (FILTER)
unnamed: R1.1, R2.1, led-driver1.6 (REXT)
