LaheyKevin/Applied-IoT-Project-PoAB/(commit log)

2023-09-21 pcb
    add pcb
    [baseboard-B_Cu.gbl, baseboard-B_Mask.gbs, baseboard-B_Paste.gbp, baseboard-B_Silkscreen.gbo, baseboard-Edge_Cuts.gm1, baseboard-F_Cu.gtl, baseboard-F_Mask.gts, baseboard-F_Paste.gtp]
2023-10-26 pcbs al580 en stcs05
    [stcs05.kicad_pcb, stcs05.kicad_sch, testboard AL5801.kicad_pcb, testboard AL5801.kicad_sch]
